Cd1314520/clawd-mochi/models/clawd_mochi/clawd_mochi_v1_holes_2.2mm.step

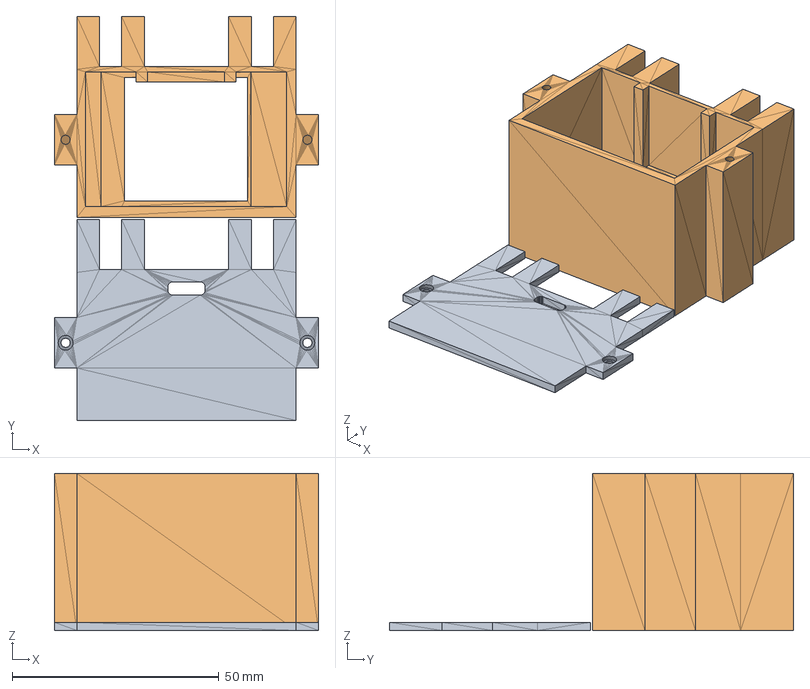
[picture p1: CAD file, 2026-10-28]
models/clawd_mochi/clawd_mochi_v1_holes_2.2mm.step
63.9 x 97.7 x 38.0 mm
