Cd1314520/clawd-mochi/(list of files, cad)

Other CAD files:
models/clawd_mochi/clawd_mochi_v1_holes_2.2mm.stl
