Cd1314520/clawd-mochi/clawd_mochi/clawd_mochi.ino

/*
 * ╔══════════════════════════════════════════════════════════════╗
 *   CLAWD MOCHI — ESP32-C3 Super Mini + ST7789 1.54" 240×240
 *
 *   Wiring:
 *     SDA → GPIO 10  (hardware SPI MOSI)
 *     SCL → GPIO 8   (hardware SPI SCK)
 *     RST → GPIO 2
 *     DC  → GPIO 1
 *     CS  → GPIO 4
 *     BL  → GPIO 3
 *     VCC → 3V3
 *     GND → GND
 *
 *   WiFi: "ClaWD-Mochi"  pw: clawd1234  → http://192.168.4.1
 *   (or set STA_SSID/STA_PASS below to join your home WiFi instead
 *    → http://clawdmochi.local)
 * ╚══════════════════════════════════════════════════════════════╝
 */

#include <Adafruit_GFX.h>
#include <Adafruit_ST7789.h>
#include <SPI.h>
#include <math.h>
#include <WiFi.h>
#include <WebServer.h>
#include <ESPmDNS.h>
#include <Update.h>
#include <time.h>

// ── Pins ──────────────────────────────────────────────────────
#define TFT_CS  4
#define TFT_DC  1
#define TFT_RST 2
#define TFT_BLK 3

Adafruit_ST7789 tft = Adafruit_ST7789(TFT_CS, TFT_DC, TFT_RST);

// ── WiFi ──────────────────────────────────────────────────────
const char* AP_SSID = "ClaWD-Mochi";
const char* AP_PASS = "clawd1234";

// Fill these in to join your home WiFi instead of hosting a hotspot —
// no more switching your phone's WiFi to reach Mochi. Leave STA_SSID
// empty ("") to keep the classic hotspot-only behaviour.
const char* STA_SSID = "";       // Fill locally; keep empty for hotspot mode.
const char* STA_PASS = "";       // Never commit your Wi-Fi password.
#define STA_TIMEOUT_MS 15000

WebServer server(80);

// ── Display ───────────────────────────────────────────────────
#define DISP_W 240
#define DISP_H 240

// ── Eye constants (shared by both eye views) ──────────────────
#define EYE_W   30
#define EYE_H   60
#define EYE_GAP 120
#define EYE_OX  0     // horizontal offset
#define EYE_OY  40    // vertical offset upward (subtracted from centre)

// ── Colours ───────────────────────────────────────────────────
uint16_t C_ORANGE, C_DARKBG, C_MUTED, C_GREEN;
#define C_WHITE ST77XX_WHITE
#define C_BLACK ST77XX_BLACK

// ── State ─────────────────────────────────────────────────────
#define VIEW_EYES_NORMAL 0
#define VIEW_EYES_SQUISH 1
#define VIEW_CODE        2
#define VIEW_DRAW        3

uint8_t  currentView  = VIEW_EYES_NORMAL;
bool     busy         = false;
bool     backlightOn  = true;
uint8_t  animSpeed    = 1;   // 1=slow(default) 2=normal 3=fast

uint16_t animBgColor  = 0;   // background for eye/logo animations
uint16_t drawBgColor  = 0;   // background for canvas

bool     uiStarted    = false;  // false until first view draw (keeps boot info screen)
uint32_t nextIdleAt   = 0;      // next random blink/glance
bool     staUp        = false;  // STA currently connected
uint32_t nextWifiTick = 0;      // next reconnect check
uint32_t wifiDownAt   = 0;      // when the connection was first seen down
bool     breathing    = false;  // backlight pulse = "unread notification"
bool     sleeping     = false;  // PC locked — eyes closed, slow dim breathing
uint8_t  faceIdx      = 0;      // which of the FACE_COUNT faces is showing
uint32_t nextFaceAt   = 0;      // next random face rotation

#define FACE_COUNT      10
#define FACE_MIN_MS  120000     // rotate every 2–6 min
#define FACE_RND_MS  240000

// ponytail: night hours hardcoded 00:00–08:00, tz Central (US)
#define TZ_STRING   "CST6CDT,M3.2.0,M11.1.0"
#define NIGHT_UNTIL 8
#define NIGHT_DUTY  25

// ── Terminal ──────────────────────────────────────────────────
#define TERM_COLS      15
#define TERM_ROWS       8
#define TERM_CHAR_W    12
#define TERM_CHAR_H    20
#define TERM_PAD_X      8
#define TERM_PAD_Y     18

bool    termMode    = false;
String  termLines[TERM_ROWS];
uint8_t termRow     = 0;
uint8_t termCol     = 0;

// ── Logo data ─────────────────────────────────────────────────
#define LOGO_CX 120
#define LOGO_CY 105

#define LOGO_TRI_COUNT 162
static const int16_t LOGO_TRIS[][6] PROGMEM = {
  {120,105,65,134,100,114},{120,105,100,114,101,113},{120,105,101,113,100,112},
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
  {136,76,144,67},{144,67,156,51},{156,51,162,45},{162,45,168,38},
  {168,38,172,35},{172,35,180,35},{180,35,185,43},{185,43,183,52},
  {183,52,175,62},{175,62,168,71},{168,71,159,83},{159,83,153,94},
  {153,94,154,94},{154,94,155,94},{155,94,176,90},{176,90,188,88},
  {188,88,201,85},{201,85,208,88},{208,88,208,91},{208,91,206,97},
  {206,97,191,101},{191,101,174,104},{174,104,148,110},{148,110,148,111},
  {148,111,148,111},{148,111,160,112},{160,112,165,112},{165,112,177,112},
  {177,112,200,114},{200,114,205,118},{205,118,209,123},{209,123,208,126},
  {208,126,199,131},{199,131,187,128},{187,128,159,121},{159,121,149,119},
  {149,119,147,119},{147,119,147,120},{147,120,156,128},{156,128,170,141},
  {170,141,189,158},{189,158,190,163},{190,163,188,166},{188,166,185,166},
  {185,166,169,153},{169,153,162,148},{162,148,148,136},{148,136,147,136},
  {147,136,147,137},{147,137,150,142},{150,142,168,168},{168,168,169,176},
  {169,176,168,179},{168,179,163,180},{163,180,158,179},{158,179,148,165},
  {148,165,137,149},{137,149,129,134},{129,134,128,135},{128,135,123,189},
  {123,189,120,192},{120,192,115,194},{115,194,110,191},{110,191,108,185},
  {108,185,110,174},{110,174,113,160},{113,160,116,148},{116,148,118,134},
  {118,134,119,129},{119,129,119,129},{119,129,118,129},{118,129,107,144},
  {107,144,91,166},{91,166,78,180},{78,180,75,181},{75,181,70,178},
  {70,178,70,173},{70,173,73,169},{73,169,91,146},{91,146,102,132},
  {102,132,109,124},{109,124,109,123},{109,123,108,123},{108,123,61,153},
  {61,153,52,155},{52,155,49,151},{49,151,49,146},{49,146,51,144},
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
};

// ═════════════════════════════════════════════════════════════
//  HELPERS
// ═════════════════════════════════════════════════════════════

int speedMs(int ms) {
  if (animSpeed == 3) return ms / 2;
  if (animSpeed == 1) return ms * 2;
  return ms;
}

uint16_t hexToRgb565(String hex) {
  hex.replace("#", "");
  if (hex.length() != 6) return C_WHITE;
  long v = strtol(hex.c_str(), nullptr, 16);
  return tft.color565((v >> 16) & 0xFF, (v >> 8) & 0xFF, v & 0xFF);
}

void setBacklight(bool on) { backlightOn = on; }  // blTick applies the duty

// Single owner of the backlight PWM: off / breathing pulse / night-dim / full.
void blTick() {
  static uint8_t lastDuty = 1;   // impossible initial so first call always writes
  uint8_t duty;
  if (!backlightOn) {
    duty = 0;
  } else if (sleeping) {
    duty = 14 + (int8_t)(10.0f * sinf(millis() / 1500.0f));  // slow, faint — asleep
  } else if (breathing) {
    duty = 130 + (int8_t)(110.0f * sinf(millis() / 500.0f));
  } else {
    duty = 255;
    struct tm t;
    if (getLocalTime(&t, 0) && t.tm_year > 120 && t.tm_hour < NIGHT_UNTIL)
      duty = NIGHT_DUTY;         // it stays up with you, but dims at night
  }
  if (duty != lastDuty) { ledcWrite(TFT_BLK, duty); lastDuty = duty; }
}

void initColours() {
  // C_ORANGE = tft.color565(170, 72, 28);
  C_ORANGE = tft.color565(218, 17, 0);
  C_DARKBG = tft.color565(10,  12,  16);
  C_MUTED  = tft.color565(90,  88,  86);
  C_GREEN  = tft.color565(80, 220, 130);
  animBgColor = C_ORANGE;
  drawBgColor = C_ORANGE;
}

// ═════════════════════════════════════════════════════════════
//  LOGO
// ═════════════════════════════════════════════════════════════

void drawLogoFilled(uint16_t bg, uint16_t fg) {
  tft.fillScreen(bg);
  for (uint16_t i = 0; i < LOGO_TRI_COUNT; i++) {
    tft.fillTriangle(
      pgm_read_word(&LOGO_TRIS[i][0]), pgm_read_word(&LOGO_TRIS[i][1]),
      pgm_read_word(&LOGO_TRIS[i][2]), pgm_read_word(&LOGO_TRIS[i][3]),
      pgm_read_word(&LOGO_TRIS[i][4]), pgm_read_word(&LOGO_TRIS[i][5]),
      fg);
  }
  tft.setTextColor(fg); tft.setTextSize(2);
  tft.setCursor(LOGO_CX - 54, 210); tft.print("Anthropic");
  tft.setCursor(LOGO_CX - 53, 210); tft.print("Anthropic");
}

// ═════════════════════════════════════════════════════════════
//  VIEWS
// ═════════════════════════════════════════════════════════════

// Eye helpers — shared constants via #define EYE_*
inline int16_t eyeLX(int16_t ox) {
  return (DISP_W - (EYE_W * 2 + EYE_GAP)) / 2 + EYE_OX + ox;
}
inline int16_t eyeRX(int16_t ox) { return eyeLX(ox) + EYE_W + EYE_GAP; }
inline int16_t eyeY()            { return (DISP_H - EYE_H) / 2 - EYE_OY; }
inline int16_t eyeCY()           { return eyeY() + EYE_H / 2; }

void drawNormalEyes(int16_t ox = 0, bool blink = false) {
  uiStarted = true;
  tft.fillScreen(animBgColor);
  const int16_t lx = eyeLX(ox), rx = eyeRX(ox), ey = eyeY();
  if (!blink) {
    tft.fillRect(lx, ey, EYE_W, EYE_H, C_BLACK);
    tft.fillRect(rx, ey, EYE_W, EYE_H, C_BLACK);
  } else {
    tft.fillRect(lx, ey + EYE_H / 2 - 3, EYE_W, 6, C_BLACK);
    tft.fillRect(rx, ey + EYE_H / 2 - 3, EYE_W, 6, C_BLACK);
  }
}

void drawChevron(int16_t cx, int16_t cy, int16_t arm, int16_t reach,
                 uint8_t thk, bool rightFacing, uint16_t col) {
  for (int8_t t = -(int8_t)thk; t <= (int8_t)thk; t++) {
    if (rightFacing) {
      tft.drawLine(cx - reach/2, cy - arm + t, cx + reach/2, cy + t,      col);
      tft.drawLine(cx + reach/2, cy + t,       cx - reach/2, cy + arm + t, col);
    } else {
      tft.drawLine(cx + reach/2, cy - arm + t, cx - reach/2, cy + t,      col);
      tft.drawLine(cx - reach/2, cy + t,       cx + reach/2, cy + arm + t, col);
    }
  }
}

void drawSquishEyes(bool closed = false) {
  uiStarted = true;
  tft.fillScreen(animBgColor);
  const int16_t lx = eyeLX(0), rx = eyeRX(0), cy = eyeCY();
  const int16_t arm   = EYE_H / 2;
  const int16_t reach = EYE_W / 2;
  const int16_t lcx   = lx + EYE_W / 2;
  const int16_t rcx   = rx + EYE_W / 2;
  if (!closed) {
    drawChevron(lcx, cy, arm, reach, 10, true,  C_BLACK);
    drawChevron(rcx, cy, arm, reach, 10, false, C_BLACK);
  } else {
    tft.fillRect(lx, cy - 5, EYE_W, 10, C_BLACK);
    tft.fillRect(rx, cy - 5, EYE_W, 10, C_BLACK);
  }
}

// ── Extra faces (2–9) — all drawn at the standard eye positions ──
void drawFaceSleepy() {          // 2: half-lidded
  uiStarted = true;
  tft.fillScreen(animBgColor);
  tft.fillRect(eyeLX(0), eyeY() + EYE_H / 2, EYE_W, EYE_H / 2, C_BLACK);
  tft.fillRect(eyeRX(0), eyeY() + EYE_H / 2, EYE_W, EYE_H / 2, C_BLACK);
}

void drawFaceWide() {            // 3: surprised round eyes with a glint
  uiStarted = true;
  tft.fillScreen(animBgColor);
  const int16_t cy = eyeCY();
  for (int8_t s = 0; s < 2; s++) {
    const int16_t cx = (s ? eyeRX(0) : eyeLX(0)) + EYE_W / 2;
    tft.fillCircle(cx, cy, EYE_W, C_BLACK);
    tft.fillCircle(cx + 9, cy - 9, 6, C_WHITE);
  }
}

void drawFaceWink() {            // 4: left open, right closed
  uiStarted = true;
  tft.fillScreen(animBgColor);
  tft.fillRect(eyeLX(0), eyeY(), EYE_W, EYE_H, C_BLACK);
  tft.fillRect(eyeRX(0), eyeCY() - 4, EYE_W, 8, C_BLACK);
}

void drawHeart(int16_t cx, int16_t cy, int16_t s, uint16_t col) {
  tft.fillCircle(cx - s / 2, cy - s / 3, s / 2 + 2, col);
  tft.fillCircle(cx + s / 2, cy - s / 3, s / 2 + 2, col);
  tft.fillTriangle(cx - s - 1, cy - s / 6, cx + s + 1, cy - s / 6, cx, cy + s, col);
}

void drawFaceHearts() {          // 5: heart eyes
  uiStarted = true;
  tft.fillScreen(animBgColor);
  const uint16_t red = tft.color565(235, 30, 60);
  drawHeart(eyeLX(0) + EYE_W / 2, eyeCY(), 20, red);
  drawHeart(eyeRX(0) + EYE_W / 2, eyeCY(), 20, red);
}

void drawFaceDizzy() {           // 6: X X eyes
  uiStarted = true;
  tft.fillScreen(animBgColor);
  for (int8_t s = 0; s < 2; s++) {
    const int16_t x = s ? eyeRX(0) : eyeLX(0), y = eyeCY() - EYE_W / 2;
    for (int8_t t = -3; t <= 3; t++) {
      tft.drawLine(x + t, y, x + EYE_W + t, y + EYE_W, C_BLACK);
      tft.drawLine(x + EYE_W + t, y, x + t, y + EYE_W, C_BLACK);
    }
  }
}

void drawFaceAngry() {           // 7: slanted inner brows over rect eyes
  uiStarted = true;
  tft.fillScreen(animBgColor);
  const int16_t lx = eyeLX(0), rx = eyeRX(0), ey = eyeY();
  tft.fillRect(lx, ey, EYE_W, EYE_H, C_BLACK);
  tft.fillRect(rx, ey, EYE_W, EYE_H, C_BLACK);
  tft.fillTriangle(lx, ey, lx + EYE_W, ey, lx + EYE_W, ey + 20, animBgColor);  // inner = right
  tft.fillTriangle(rx, ey + 20, rx, ey, rx + EYE_W, ey, animBgColor);          // inner = left
}

void drawFaceSus() {             // 8: narrow side-eye squint
  uiStarted = true;
  tft.fillScreen(animBgColor);
  tft.fillRect(eyeLX(10), eyeCY() - 9, EYE_W, 18, C_BLACK);
  tft.fillRect(eyeRX(10), eyeCY() - 9, EYE_W, 18, C_BLACK);
}

void drawFaceContent() {         // 9: happy closed arcs (∩ ∩)
  uiStarted = true;
  tft.fillScreen(animBgColor);
  const int16_t cy = eyeCY();
  for (int8_t s = 0; s < 2; s++) {
    const int16_t cx = (s ? eyeRX(0) : eyeLX(0)) + EYE_W / 2;
    tft.fillCircle(cx, cy, EYE_W / 2 + 6, C_BLACK);
    tft.fillCircle(cx, cy, EYE_W / 2 - 3, animBgColor);
    tft.fillRect(cx - EYE_W / 2 - 7, cy, EYE_W + 14, EYE_W / 2 + 8, animBgColor);
  }
}

void drawFace(uint8_t i) {
  switch (i) {
    default:
    case 0: drawNormalEyes();   break;
    case 1: drawSquishEyes();   break;
    case 2: drawFaceSleepy();   break;
    case 3: drawFaceWide();     break;
    case 4: drawFaceWink();     break;
    case 5: drawFaceHearts();   break;
    case 6: drawFaceDizzy();    break;
    case 7: drawFaceAngry();    break;
    case 8: drawFaceSus();      break;
    case 9: drawFaceContent();  break;
  }
}

void drawCodeView() {
  termMode = false;
  tft.fillScreen(C_DARKBG);
  tft.fillRect(0, 0,          DISP_W, 4, C_ORANGE);
  tft.fillRect(0, DISP_H - 4, DISP_W, 4, C_ORANGE);
  tft.setTextColor(C_ORANGE); tft.setTextSize(4);
  tft.setCursor((DISP_W - 144) / 2, DISP_H / 2 - 52); tft.print("Claude");
  tft.setTextColor(C_WHITE);  tft.setTextSize(4);
  tft.setCursor((DISP_W - 96) / 2,  DISP_H / 2 + 8);  tft.print("Code");
  tft.fillRect((DISP_W - 96) / 2, DISP_H / 2 + 52, 96, 3, C_ORANGE);
}

// ═════════════════════════════════════════════════════════════
//  TERMINAL
// ═════════════════════════════════════════════════════════════

void termClear() {
  for (uint8_t i = 0; i < TERM_ROWS; i++) termLines[i] = "";
  termRow = 0; termCol = 0;
}

void termDrawHeader() {
  tft.fillRect(0, 0, DISP_W, TERM_PAD_Y + 1, C_DARKBG);
  tft.setTextColor(C_ORANGE); tft.setTextSize(1);
  tft.setCursor(TERM_PAD_X, 4); tft.print("clawd@mochi terminal");
  tft.drawFastHLine(0, TERM_PAD_Y, DISP_W, C_ORANGE);
}

// Prefix "clawd:~$ " in green, drawn only when the row has content
void termDrawPrefix(int16_t yy) {
  tft.setTextColor(C_GREEN); tft.setTextSize(1);
  tft.setCursor(TERM_PAD_X, yy + 6);
  tft.print("clawd:~$ ");
}

#define PREFIX_PX 54   // 9 chars × 6px = 54px at textSize 1

void termDrawLine(uint8_t r) {
  const int16_t yy = TERM_PAD_Y + 4 + r * TERM_CHAR_H;
  tft.fillRect(0, yy, DISP_W, TERM_CHAR_H, C_DARKBG);
  // show prefix only on the currently active (cursor) line
  if (r == termRow) termDrawPrefix(yy);
  tft.setTextColor(C_WHITE); tft.setTextSize(2);
  tft.setCursor(TERM_PAD_X + PREFIX_PX, yy + 1);
  tft.print(termLines[r]);
  if (r == termRow) {
    const int16_t cx = TERM_PAD_X + PREFIX_PX + termCol * TERM_CHAR_W;
    tft.fillRect(cx, yy + 1, TERM_CHAR_W - 2, TERM_CHAR_H - 2, C_GREEN);
  }
}

void termDrawLastChar() {
  if (termCol == 0) return;
  const int16_t yy    = TERM_PAD_Y + 4 + termRow * TERM_CHAR_H;
  const int16_t baseX = TERM_PAD_X + PREFIX_PX;
  const uint8_t prev  = termCol - 1;
  // erase prev cell (had cursor block)
  tft.fillRect(baseX + prev * TERM_CHAR_W, yy + 1, TERM_CHAR_W, TERM_CHAR_H - 1, C_DARKBG);
  tft.setTextColor(C_WHITE); tft.setTextSize(2);
  tft.setCursor(baseX + prev * TERM_CHAR_W, yy + 1);
  tft.print(termLines[termRow][prev]);
  // new cursor
  tft.fillRect(baseX + termCol * TERM_CHAR_W, yy + 1, TERM_CHAR_W - 2, TERM_CHAR_H - 2, C_GREEN);
}

void termDrawBackspace() {
  const int16_t yy    = TERM_PAD_Y + 4 + termRow * TERM_CHAR_H;
  const int16_t baseX = TERM_PAD_X + PREFIX_PX;
  // erase deleted char + old cursor
  tft.fillRect(baseX + termCol * TERM_CHAR_W, yy + 1, TERM_CHAR_W * 2, TERM_CHAR_H - 1, C_DARKBG);
  // new cursor
  tft.fillRect(baseX + termCol * TERM_CHAR_W, yy + 1, TERM_CHAR_W - 2, TERM_CHAR_H - 2, C_GREEN);
  // if line now empty, erase the prefix too
  if (termLines[termRow].length() == 0) {
    tft.fillRect(0, yy, TERM_PAD_X + PREFIX_PX, TERM_CHAR_H, C_DARKBG);
  }
}

void termFullRedraw() {
  tft.fillScreen(C_DARKBG);
  termDrawHeader();
  for (uint8_t r = 0; r < TERM_ROWS; r++) termDrawLine(r);
}

void termScroll() {
  for (uint8_t i = 0; i < TERM_ROWS - 1; i++) termLines[i] = termLines[i + 1];
  termLines[TERM_ROWS - 1] = "";
  termRow = TERM_ROWS - 1;
  termFullRedraw();
}

void termAddChar(char c) {
  if (c == '\n' || c == '\r') {
    const int16_t yy = TERM_PAD_Y + 4 + termRow * TERM_CHAR_H;
    // erase cursor on current row
    tft.fillRect(TERM_PAD_X + PREFIX_PX + termCol * TERM_CHAR_W,
                 yy + 1, TERM_CHAR_W, TERM_CHAR_H - 1, C_DARKBG);
    termRow++; termCol = 0;
    if (termRow >= TERM_ROWS) { termScroll(); return; }
    termDrawLine(termRow);  // draws prefix on new line
  } else if (c == '\b' || c == 127) {
    if (termCol > 0) {
      termCol--;
      termLines[termRow].remove(termLines[termRow].length() - 1);
      termDrawBackspace();
    }
  } else if (c >= 32 && c < 127) {
    if (termCol >= TERM_COLS) {
      termRow++; termCol = 0;
      if (termRow >= TERM_ROWS) { termScroll(); return; }
    }
    // draw prefix on first char of this line
    if (termCol == 0) termDrawPrefix(TERM_PAD_Y + 4 + termRow * TERM_CHAR_H);
    termLines[termRow] += c;
    termCol++;
    termDrawLastChar();
  }
}

// ═════════════════════════════════════════════════════════════
//  ANIMATIONS
// ═════════════════════════════════════════════════════════════

void animNormalEyes() {
  busy = true;
  const int16_t offs[] = {-16, 16, -16, 16, 0};
  for (uint8_t i = 0; i < 5; i++) { drawNormalEyes(offs[i]); delay(speedMs(80)); }
  drawNormalEyes(0, true);  delay(speedMs(100));
  drawNormalEyes(0, false); delay(speedMs(70));
  drawNormalEyes(0, true);  delay(speedMs(70));
  drawNormalEyes(0, false);
  busy = false;
}

void animSquishEyes() {
  busy = true;
  for (uint8_t i = 0; i < 3; i++) {
    drawSquishEyes(false); delay(speedMs(160));
    drawSquishEyes(true);  delay(speedMs(100));
  }
  drawSquishEyes(false);
  busy = false;
}

void animLogoReveal() {
  busy = true;
  tft.fillScreen(animBgColor);
  for (uint16_t i = 0; i < LOGO_SEG_COUNT; i++) {
    int16_t x1 = pgm_read_word(&LOGO_SEGS[i][0]);
    int16_t y1 = pgm_read_word(&LOGO_SEGS[i][1]);
    int16_t x2 = pgm_read_word(&LOGO_SEGS[i][2]);
    int16_t y2 = pgm_read_word(&LOGO_SEGS[i][3]);
    tft.drawLine(x1, y1, x2, y2, C_WHITE);
    tft.drawLine(x1 + 1, y1, x2 + 1, y2, C_WHITE);
    if (i % 4 == 0) { server.handleClient(); delay(speedMs(8)); }
  }
  drawLogoFilled(animBgColor, C_WHITE);
  delay(1500);
  busy = false;
}

// ── Idle life — random blinks, glances & face rotation ─────────
void idleTick() {
  if (!uiStarted || busy || termMode || sleeping) return;
  if (currentView != VIEW_EYES_NORMAL && currentView != VIEW_EYES_SQUISH) return;
  if (millis() < nextIdleAt) return;

  // every few minutes: swap to a random face
  if (nextFaceAt == 0) nextFaceAt = millis() + FACE_MIN_MS + random(FACE_RND_MS);
  if (millis() > nextFaceAt) {
    faceIdx = random(FACE_COUNT);
    busy = true; drawFace(faceIdx); busy = false;
    nextFaceAt = millis() + FACE_MIN_MS + random(FACE_RND_MS);
    nextIdleAt = millis() + 2500 + random(4500);
    return;
  }

  busy = true;
  if (faceIdx == 0) {
    if (random(4) == 0) {                       // 1-in-4: glance to the side
      drawNormalEyes(random(2) ? 14 : -14);
      delay(280);
      drawNormalEyes(0);
    } else {                                    // otherwise: blink
      drawNormalEyes(0, true);
      delay(110);
      drawNormalEyes(0, false);
    }
  } else if (faceIdx == 1) {
    drawSquishEyes(true);
    delay(120);
    drawSquishEyes(false);
  }                                             // other faces hold still until rotation
  busy = false;
  nextIdleAt = millis() + 2500 + random(4500);  // next one in 2.5–7 s
}

// Static IP so /notify scripts never chase a DHCP lease — must be re-declared
// on every (re)join or the driver silently falls back to DHCP.
// ponytail: hardcoded to the Windows-hotspot subnet (gateway .1)
void staBegin() {
  WiFi.config(IPAddress(192,168,137,50), IPAddress(192,168,137,1),
              IPAddress(255,255,255,0), IPAddress(192,168,137,1));
  WiFi.begin(STA_SSID, STA_PASS);
}

// ── WiFi self-heal — the PC hotspot comes and goes with sleep ──
// Reconnects when the hotspot returns; also rescues the boot-time
// AP-fallback case without needing a USB replug.
void wifiTick() {
  if (strlen(STA_SSID) == 0 || millis() < nextWifiTick) return;
  nextWifiTick = millis() + 10000;
  if (WiFi.status() == WL_CONNECTED) {
    wifiDownAt = 0;
    if (!staUp) {                 // just (re)joined — e.g. recovered from AP fallback
      staUp = true;
      WiFi.setSleep(false);
      MDNS.begin("clawdmochi");
    }
    return;
  }
  staUp = false;
  if (wifiDownAt == 0) wifiDownAt = millis();
  // Asleep with no network for 10+ min: the wake command can never reach us,
  // so stop looking dead and wake up on our own.
  if (sleeping && millis() - wifiDownAt > 600000) {
    sleeping = false;
    animNormalEyes();
  }
  // ponytail: screen keeps whatever it shows during retries; IP is on /state
  if (WiFi.getMode() == WIFI_AP) WiFi.mode(WIFI_AP_STA);  // keep AP alive as fallback
  staBegin();
}

// ═════════════════════════════════════════════════════════════
//  WEB PAGE
// ═════════════════════════════════════════════════════════════
const char INDEX_HTML[] PROGMEM = R"rawhtml(
<!DOCTYPE html>
<html lang="en">
<head>
<meta charset="UTF-8">
<meta name="viewport" content="width=device-width,initial-scale=1,user-scalable=no">
<title>Clawd Mochi</title>
<style>
*{box-sizing:border-box;margin:0;padding:0;-webkit-tap-highlight-color:transparent}
body{background:#1c1c20;font-family:'Courier New',monospace;color:#e8e4dc;
  display:flex;flex-direction:column;align-items:center;
  padding:20px 14px 52px;gap:14px;min-height:100vh}

.hdr{text-align:center;padding:2px 0 4px}
.mascot{font-size:15px;color:#c96a3e;line-height:1.3;font-weight:bold;
  font-family:'Courier New',monospace;display:block;letter-spacing:1px}
.sitename{font-size:10px;color:#5a5048;margin-top:8px;letter-spacing:3px}

.sec{width:100%;max-width:390px;font-size:10px;color:#8a8278;
  letter-spacing:2px;font-weight:bold;padding:0 2px}

/* Busy bar */
.busy{width:100%;max-width:390px;height:2px;background:#2e2a28;
  border-radius:1px;overflow:hidden;opacity:0;transition:opacity .2s}
.busy.show{opacity:1}
.busy-i{height:100%;width:30%;background:#c96a3e;border-radius:1px;
  animation:sl 1s linear infinite}
@keyframes sl{0%{margin-left:-30%}100%{margin-left:100%}}

/* Controls */
.ctrl{display:flex;gap:8px;width:100%;max-width:390px}
.cbtn{flex:1;background:#252428;border:1.5px solid #38343a;border-radius:10px;
  color:#b8b4ac;font-family:'Courier New',monospace;font-size:11px;font-weight:bold;
  padding:12px 4px;cursor:pointer;text-align:center;transition:all .12s}
.cbtn:active:not(:disabled){transform:scale(.94)}
.cbtn:disabled{opacity:.3;cursor:default}
.cbtn.on{border-color:#c96a3e;color:#c96a3e;background:#201408}
.cbtn.dim{border-color:#2e2a28;color:#4a4540}

/* View grid */
.vgrid{display:grid;grid-template-columns:1fr 1fr;gap:8px;width:100%;max-width:390px}
.vbtn{background:#252428;border:1.5px solid #38343a;border-radius:12px;
  color:#d8d4cc;font-family:'Courier New',monospace;
  padding:14px 6px 10px;cursor:pointer;text-align:center;
  transition:all .12s;user-select:none}
.vbtn:active:not(:disabled){transform:scale(.94)}
.vbtn:disabled{opacity:.3;cursor:default}
.vbtn .ic{font-size:20px;display:block;margin-bottom:4px;line-height:1;color:#c96a3e}
.vbtn .nm{font-size:12px;font-weight:bold;color:#e8e4dc}
.vbtn .ht{font-size:9px;color:#8a8278;margin-top:3px}
.vbtn.active{border-color:#c96a3e;background:#201408}
.vbtn[data-v="1"].active{border-color:#c96a3e;background:#201408}
.vbtn[data-v="2"].active{border-color:#4a8acd;background:#0c1628}
.vbtn[data-v="3"].active{border-color:#38343a;background:#201c18}

/* Speed slider */
.speed-row{width:100%;max-width:390px;display:flex;align-items:center;gap:10px}
.sl{font-size:10px;color:#6a6058;white-space:nowrap;min-width:36px}
input[type=range]{flex:1;accent-color:#c96a3e;cursor:pointer;height:20px}
.sv{font-size:11px;color:#c96a3e;min-width:44px;text-align:right;font-weight:bold}

/* Terminal */
.twrap{width:100%;max-width:390px;display:none;flex-direction:column;gap:8px}
.twrap.open{display:flex}
.thdr{display:flex;justify-content:space-between;align-items:center}
.tttl{font-size:11px;color:#28b878;letter-spacing:1px;font-weight:bold}
.tx{background:#0c1e12;border:2px solid #1a4828;border-radius:9px;
  color:#28b878;font-family:'Courier New',monospace;font-size:13px;
  font-weight:bold;padding:10px 18px;cursor:pointer}
.tx:active{background:#081410}
.trow{display:flex;gap:6px}
.tin{flex:1;background:#0c1018;border:1.5px solid #1a2820;border-radius:9px;
  color:#40d880;font-family:'Courier New',monospace;font-size:15px;
  padding:11px;outline:none}
.tin::placeholder{color:#2a3828}
.tgo{background:#1a9060;border:none;border-radius:9px;color:#fff;
  font-family:'Courier New',monospace;font-size:22px;font-weight:bold;
  padding:11px 16px;cursor:pointer;min-width:52px}
.tgo:active{background:#0f6040}

/* Canvas */
.cwrap{width:100%;max-width:390px;background:#222028;border:1.5px solid #38343a;
  border-radius:12px;padding:12px;flex-direction:column;gap:10px;display:none}
.cwrap.open{display:flex}
.crow{display:flex;gap:8px}
.ci{display:flex;flex-direction:column;align-items:center;gap:4px;flex:1}
.cl{font-size:10px;color:#7a7068;letter-spacing:1px;font-weight:bold}
.cs{width:100%;height:38px;border-radius:7px;border:1.5px solid #38343a;cursor:pointer;padding:0}
.dacts{display:flex;gap:7px}
.db{flex:1;background:#1c1820;border:1.5px solid #38343a;border-radius:9px;
  color:#c0bab8;font-family:'Courier New',monospace;font-size:11px;
  font-weight:bold;padding:11px 4px;cursor:pointer;transition:all .12s}
.db:active{transform:scale(.95);background:#281838}
.db.hi{border-color:#c96a3e;color:#c96a3e}
canvas{width:100%;border-radius:8px;border:1.5px solid #38343a;
  touch-action:none;cursor:crosshair;display:block}

/* Toast */
.toast{position:fixed;bottom:18px;left:50%;transform:translateX(-50%);
  background:#252428;border:1.5px solid #38343a;border-radius:9px;
  font-size:12px;color:#d8d4cc;padding:7px 16px;opacity:0;
  transition:opacity .18s;pointer-events:none;white-space:nowrap;z-index:99}
.toast.show{opacity:1}
</style>
</head>
<body>

<div class="hdr">
  <span class="mascot">&#x2590;&#x259B;&#x2588;&#x2588;&#x2588;&#x259C;&#x258C;<br>&#x259C;&#x2588;&#x2588;&#x2588;&#x2588;&#x2588;&#x259B;<br>&#x2598;&#x2598;&nbsp;&#x259D;&#x259D;</span>
  <div class="sitename">CLAWD &middot; MOCHI &middot; CONTROLLER</div>
</div>

<div class="busy" id="busy"><div class="busy-i"></div></div>

<div class="sec">// controls</div>
<div class="ctrl">
  <button class="cbtn on" id="blBtn" onclick="toggleBL()">&#9728; display on</button>
</div>

<div class="sec">// views</div>
<div class="vgrid">
  <button class="vbtn active" data-v="0" onclick="setView(0)">
    <span class="ic">&#9632; &#9632;</span>
    <span class="nm">Normal eyes</span>
    <span class="ht">wiggle + blink</span>
  </button>
  <button class="vbtn" data-v="1" onclick="setView(1)">
    <span class="ic">&gt; &lt;</span>
    <span class="nm">Squish eyes</span>
    <span class="ht">open / close</span>
  </button>
  <button class="vbtn" data-v="2" onclick="setView(2)">
    <span class="ic">{ }</span>
    <span class="nm">Claude Code</span>
    <span class="ht">opens terminal</span>
  </button>
  <button class="vbtn" data-v="3" onclick="toggleCanvas()">
    <span class="ic">&#11035;</span>
    <span class="nm">Canvas</span>
    <span class="ht">draw on display</span>
  </button>
</div>

<div class="sec">// speed</div>
<div class="speed-row">
  <span class="sl">slow</span>
  <input type="range" id="spd" min="1" max="3" value="1" step="1" oninput="setSpeed(this.value)">
  <span class="sv" id="spdV">slow</span>
</div>

<div class="ctrl">
  <div class="ci" style="flex:1;display:flex;flex-direction:column;gap:4px;align-items:stretch">
    <span class="cl" style="font-size:10px;color:#8a8278;letter-spacing:1px;font-weight:bold;text-align:center">BACKGROUND</span>
    <input type="color" class="cs" id="bgCol" value="#aa4818" oninput="onBgChange(this.value)">
  </div>
  <div class="ci" style="flex:1;display:flex;flex-direction:column;gap:4px;align-items:stretch">
    <span class="cl" style="font-size:10px;color:#8a8278;letter-spacing:1px;font-weight:bold;text-align:center">PEN COLOR</span>
    <input type="color" class="cs" id="penCol" value="#000000">
  </div>
</div>

<div class="sec">// terminal</div>
<div class="twrap" id="twrap">
  <div class="thdr">
    <span class="tttl">&#9658; clawd:~$</span>
    <button class="tx" onclick="closeTerm()">&#x2715; exit terminal</button>
  </div>
  <div class="trow">
    <input class="tin" id="tin" type="text" placeholder="type here..."
           autocomplete="off" autocorrect="off" autocapitalize="off" spellcheck="false">
    <button class="tgo" onclick="termEnter()">&#8629;</button>
  </div>
</div>

<div class="cwrap" id="cwrap">
  <div class="dacts">
    <button class="db hi" onclick="clearAll()">&#11035; clear</button>
    <button class="db" style="border-color:#28b878;color:#28b878" onclick="toggleCanvas()">&#10003; done</button>
  </div>
  <canvas id="cvs" width="240" height="240"></canvas>
</div>

<div class="toast" id="toast"></div>

<script>
let activeView  = 0;
let termOpen    = false;
let canvasOpen  = false;
let blOn        = true;
let isBusy      = false;
let drawing     = false;
let lastX = 0, lastY = 0;
let tt;

const spdLabels = ['','slow','normal','fast'];

// ── Toast ──────────────────────────────────────────────────────
function toast(msg, ok=true) {
  const el = document.getElementById('toast');
  el.textContent = msg;
  el.style.borderColor = ok ? '#28b878' : '#c96a3e';
  el.classList.add('show');
  clearTimeout(tt);
  tt = setTimeout(() => el.classList.remove('show'), 1300);
}

// ── Busy ────────────────────────────────────────────────────────
function setBusy(b) {
  isBusy = b;
  document.getElementById('busy').classList.toggle('show', b);
  const locked = b || termOpen;
  document.querySelectorAll('.vbtn').forEach(el => {
    // when canvas open, keep canvas btn (data-v=3) active so user can exit
    el.disabled = canvasOpen ? parseInt(el.dataset.v) !== 3 : locked;
  });
  document.querySelectorAll('.lbtn').forEach(el => el.disabled = locked || canvasOpen);
  document.querySelectorAll('.cbtn').forEach(el => {
    if (el.id !== 'blBtn') el.disabled = locked;
  });
}

// ── HTTP ────────────────────────────────────────────────────────
async function req(path) {
  try { const r = await fetch(path); return r.ok; }
  catch(e) { toast('no connection', false); return false; }
}

async function waitNotBusy() {
  for (let i = 0; i < 100; i++) {
    try {
      const r = await fetch('/state');
      const j = await r.json();
      if (!j.busy) return;
    } catch(e) {}
    await new Promise(r => setTimeout(r, 150));
  }
}

// ── Background colour ───────────────────────────────────────────
async function onBgChange(hex) {
  if (canvasOpen) {
    await req('/draw/clear?bg=' + encodeURIComponent(hex));
  } else {
    await req('/redraw?bg=' + encodeURIComponent(hex));
  }
  redrawCanvas(hex);
}

// ── Speed ───────────────────────────────────────────────────────
async function setSpeed(v) {
  document.getElementById('spdV').textContent = spdLabels[v];
  await req('/speed?v=' + v);
}

// ── Views ───────────────────────────────────────────────────────
async function setView(v) {
  if (isBusy || termOpen || canvasOpen) return;
  if (v === 3) { toggleCanvas(); return; }  // canvas button in grid
  const keys = ['w','s','d'];
  if (!await req('/cmd?k=' + keys[v])) return;
  activeView = v;
  document.querySelectorAll('.vbtn').forEach(b =>
    b.classList.toggle('active', parseInt(b.dataset.v) === v));
  if (v === 2) {
    termOpen = true;
    document.getElementById('twrap').classList.add('open');
    setBusy(false);   // re-run to apply termOpen lock
    setBusy(false);
    document.querySelectorAll('.vbtn,.lbtn').forEach(b => b.disabled = true);
    const cvb = document.getElementById('cvBtn'); if (cvb) cvb.disabled = true;
    document.getElementById('tin').focus();
    toast('terminal open');
    return;
  }
  setBusy(true);
  await waitNotBusy();
  setBusy(false);
}

// ── Logo animations (kept for startup, not exposed in UI) ──────

// ── Backlight ───────────────────────────────────────────────────
async function toggleBL() {
  blOn = !blOn;
  await req('/backlight?on=' + (blOn ? 1 : 0));
  const b = document.getElementById('blBtn');
  b.textContent = blOn ? '\u2600 display on' : '\u25cb display off';
  b.classList.toggle('on', blOn);
  b.classList.toggle('dim', !blOn);
}

// ── Canvas toggle ───────────────────────────────────────────────
async function toggleCanvas() {
  canvasOpen = !canvasOpen;
  document.getElementById('cwrap').classList.toggle('open', canvasOpen);
  const b = document.getElementById('cvBtn');
  if (b) { b.classList.toggle('on', canvasOpen); b.textContent = canvasOpen ? '\u2b1b canvas on' : '\u2b1b canvas'; }
  // highlight the canvas vbtn (data-v=3) in the grid
  document.querySelectorAll('.vbtn').forEach(btn =>
    btn.classList.toggle('active', canvasOpen && parseInt(btn.dataset.v) === 3));
  await req('/canvas?on=' + (canvasOpen ? 1 : 0));
  if (canvasOpen) {
    const bg = document.getElementById('bgCol').value;
    redrawCanvas(bg);
    await req('/draw/clear?bg=' + encodeURIComponent(bg));
    // lock all other buttons
    document.querySelectorAll('.vbtn,.lbtn').forEach(b => b.disabled = true);
    toast('canvas active');
  } else {
    setBusy(false);   // re-evaluate locks
    toast('canvas off');
  }
}

// ── Terminal ────────────────────────────────────────────────────
const tin = document.getElementById('tin');
let lastVal = '';
tin.addEventListener('input', async () => {
  const cur = tin.value, prev = lastVal;
  if (cur.length > prev.length) {
    await req('/char?c=' + encodeURIComponent(cur[cur.length - 1]));
  } else if (cur.length < prev.length) {
    await req('/char?c=%08');
  }
  lastVal = cur;
});
async function termEnter() {
  await req('/char?c=%0A');
  tin.value = ''; lastVal = ''; tin.focus();
}
tin.addEventListener('keydown', e => {
  if (e.key === 'Enter') { e.preventDefault(); termEnter(); }
});
async function closeTerm() {
  await req('/cmd?k=q');
  termOpen = false;
  document.getElementById('twrap').classList.remove('open');
  setBusy(false);
  toast('terminal closed');
}

// ── Canvas drawing — send full stroke on finger lift ────────────
const cvs = document.getElementById('cvs');
const ctx = cvs.getContext('2d');
let strokePts = [];

function getPos(e) {
  const r = cvs.getBoundingClientRect();
  const sx = cvs.width / r.width, sy = cvs.height / r.height;
  const s = e.touches ? e.touches[0] : e;
  return { x: (s.clientX - r.left) * sx, y: (s.clientY - r.top) * sy };
}

function redrawCanvas(hex) {
  ctx.fillStyle = hex;
  ctx.fillRect(0, 0, cvs.width, cvs.height);
}

function startDraw(e) {
  e.preventDefault();
  drawing = true;
  strokePts = [];
  const p = getPos(e); lastX = p.x; lastY = p.y;
  strokePts.push({ x: Math.round(p.x), y: Math.round(p.y) });
  // draw dot on canvas preview only — no display send yet
  ctx.beginPath(); ctx.arc(p.x, p.y, 2, 0, Math.PI * 2);
  ctx.fillStyle = document.getElementById('penCol').value; ctx.fill();
}
function moveDraw(e) {
  if (!drawing) return; e.preventDefault();
  const p = getPos(e);
  ctx.beginPath(); ctx.moveTo(lastX, lastY); ctx.lineTo(p.x, p.y);
  ctx.strokeStyle = document.getElementById('penCol').value;
  ctx.lineWidth = 4; ctx.lineCap = 'round'; ctx.stroke();
  strokePts.push({ x: Math.round(p.x), y: Math.round(p.y) });
  lastX = p.x; lastY = p.y;
}
async function endDraw(e) {
  if (!drawing) return; drawing = false;
  if (!canvasOpen || strokePts.length < 1) return;
  const pen = document.getElementById('penCol').value.replace('#', '');
  const pts = strokePts.map(p => p.x + ',' + p.y).join(';');
  await req('/draw/stroke?pen=' + pen + '&pts=' + encodeURIComponent(pts));
  strokePts = [];
}

cvs.addEventListener('mousedown',  startDraw);
cvs.addEventListener('mousemove',  moveDraw);
cvs.addEventListener('mouseup',    endDraw);
cvs.addEventListener('mouseleave', endDraw);
cvs.addEventListener('touchstart', startDraw, {passive:false});
cvs.addEventListener('touchmove',  moveDraw,  {passive:false});
cvs.addEventListener('touchend',   endDraw);

// Clear = clear both web canvas and display
async function clearAll() {
  const bg = document.getElementById('bgCol').value;
  redrawCanvas(bg);
  await req('/draw/clear?bg=' + encodeURIComponent(bg));
  toast('cleared');
}

// Init: sync speed and backlight from ESP32, reset bg to default
(async () => {
  try {
    const r = await fetch('/state');
    const j = await r.json();
    // Sync speed
    const spd = j.speed || 1;
    document.getElementById('spd').value = spd;
    document.getElementById('spdV').textContent = spdLabels[spd];
    // Sync backlight
    if (j.bl === false) {
      blOn = false;
      const b = document.getElementById('blBtn');
      b.textContent = '\u25cb display off';
      b.classList.remove('on'); b.classList.add('dim');
    }
  } catch(e) {}
  // Always reset bg picker to default orange on page load
  document.getElementById('bgCol').value = '#aa4818';
  redrawCanvas('#aa4818');
})();
</script>
</body>
</html>
)rawhtml";

// ═════════════════════════════════════════════════════════════
//  WEB ROUTES
// ═════════════════════════════════════════════════════════════

void routeRoot() {
  server.sendHeader("Cache-Control", "no-store, no-cache, must-revalidate");
  server.sendHeader("Pragma", "no-cache");
  server.send_P(200, "text/html", INDEX_HTML);
}

void routeCmd() {
  if (!server.hasArg("k") || server.arg("k").isEmpty()) {
    server.send(400, "application/json", "{\"e\":1}"); return;
  }
  const char c = server.arg("k")[0];
  breathing = false;   // user interacted — stop the notification pulse
  sleeping  = false;

  if (termMode) {
    if (c == 'q') { termMode = false; drawCodeView(); }
    server.send(200, "application/json", "{\"ok\":1}"); return;
  }

  server.send(200, "application/json", "{\"ok\":1}");
  switch (c) {
    case 'w': currentView = VIEW_EYES_NORMAL; faceIdx = 0; animNormalEyes(); break;
    case 's': currentView = VIEW_EYES_SQUISH; faceIdx = 1; animSquishEyes(); break;
    case 'd':
      currentView = VIEW_CODE; drawCodeView();
      termMode = true; termClear(); termFullRedraw(); break;
    case 'a':
      currentView = VIEW_EYES_NORMAL;
      animLogoReveal();
      break;
  }
}

void routeChar() {
  if (!termMode) { server.send(200, "application/json", "{\"ok\":1}"); return; }
  const String val = server.arg("c");
  if (val.length() > 0) termAddChar(val[0]);
  server.send(200, "application/json", "{\"ok\":1}");
}

void routeSpeed() {
  if (server.hasArg("v")) animSpeed = constrain(server.arg("v").toInt(), 1, 3);
  server.send(200, "application/json", "{\"ok\":1}");
}

void drawCurrentView() {
  switch (currentView) {
    case VIEW_EYES_NORMAL: drawNormalEyes(); break;
    case VIEW_EYES_SQUISH: drawSquishEyes(); break;
    case VIEW_CODE:        drawCodeView();   break;
    case VIEW_DRAW:        tft.fillScreen(drawBgColor); break;
  }
}

// /redraw?bg=hex — set animBg and immediately redraw current view
void routeRedraw() {
  if (server.hasArg("bg")) {
    animBgColor = hexToRgb565(server.arg("bg"));
    drawBgColor = animBgColor;
  }
  drawCurrentView();
  server.send(200, "application/json", "{\"ok\":1}");
}

void routeCanvas() {
  const bool on = server.hasArg("on") && server.arg("on") == "1";
  if (on) { currentView = VIEW_DRAW; tft.fillScreen(drawBgColor); }
  server.send(200, "application/json", "{\"ok\":1}");
}

void routeDrawClear() {
  const String bg = server.hasArg("bg") ? server.arg("bg") : "#aa4818";
  drawBgColor = hexToRgb565(bg);
  animBgColor = drawBgColor;  // keep in sync
  currentView = VIEW_DRAW; termMode = false;
  tft.fillScreen(drawBgColor);
  server.send(200, "application/json", "{\"ok\":1}");
}

void routeDrawStroke() {
  if (!server.hasArg("pts") || !server.hasArg("pen")) {
    server.send(200, "application/json", "{\"ok\":1}"); return;
  }
  const uint16_t color = hexToRgb565(server.arg("pen"));
  const String   data  = server.arg("pts");
  currentView = VIEW_DRAW;

  struct Pt { int16_t x, y; };
  Pt prev = {-1, -1};
  int start = 0;
  while (start < (int)data.length()) {
    int semi = data.indexOf(';', start);
    if (semi == -1) semi = data.length();
    String entry = data.substring(start, semi);
    const int comma = entry.indexOf(',');
    if (comma > 0) {
      const int16_t x = entry.substring(0, comma).toInt();
      const int16_t y = entry.substring(comma + 1).toInt();
      if (prev.x >= 0) {
        tft.drawLine(prev.x, prev.y, x, y, color);
        tft.drawLine(prev.x + 1, prev.y, x + 1, y, color);
        tft.drawLine(prev.x, prev.y + 1, x, y + 1, color);
      } else {
        tft.fillCircle(x, y, 2, color);
      }
      prev = {x, y};
    }
    start = semi + 1;
  }
  server.send(200, "application/json", "{\"ok\":1}");
}

void routeBacklight() {
  setBacklight(server.hasArg("on") && server.arg("on") == "1");
  server.send(200, "application/json", "{\"ok\":1}");
}

// /notify — for bots/scripts (trading bot, Claude Code hooks):
//   view=w|s|d   switch face (normal / squish / code view)
//   msg=...      open the terminal and type the message out
//   alert=good|bad  flash the whole screen green/red 3× (visible from afar)
//   breathe=1|0  pulse the backlight until the next interaction
//   sleep=1|0    PC locked/unlocked — close eyes & dim, or wake back up
//   face=0..9    jump straight to a specific face
//   bg=RRGGBB    optional background colour, hex without '#'
void routeNotify() {
  if (server.hasArg("bg")) {
    animBgColor = hexToRgb565(server.arg("bg"));
    drawBgColor = animBgColor;
  }
  const String v     = server.arg("view");
  const String msg   = server.arg("msg");
  const String alert = server.arg("alert");
  if (server.hasArg("breathe")) breathing = server.arg("breathe") == "1";
  server.send(200, "application/json", "{\"ok\":1}");
  if (server.hasArg("sleep")) {
    const bool toSleep = server.arg("sleep") == "1";
    if (toSleep && !sleeping) {
      sleeping = true; breathing = false; termMode = false;
      currentView = VIEW_EYES_NORMAL;
      drawNormalEyes(0, true);           // eyes shut
    } else if (!toSleep && sleeping) {
      sleeping = false;
      animNormalEyes();                  // wake-up wiggle & blink
    }
    return;
  }
  if (server.hasArg("face")) {
    breathing = false; sleeping = false; termMode = false;
    faceIdx = constrain(server.arg("face").toInt(), 0, FACE_COUNT - 1);
    currentView = (faceIdx == 1) ? VIEW_EYES_SQUISH : VIEW_EYES_NORMAL;
    drawFace(faceIdx);
    return;
  }
  if (alert.length() > 0 || v.length() > 0 || msg.length() > 0) {
    breathing = false;   // a fresh event supersedes the standby pulse
    sleeping  = false;
  }
  if (alert.length() > 0) {
    busy = true;
    const uint16_t col = (alert == "bad") ? tft.color565(230, 30, 30)
                                          : tft.color565(30, 210, 90);
    for (uint8_t i = 0; i < 3; i++) {
      tft.fillScreen(col);     delay(170);
      tft.fillScreen(C_BLACK); delay(110);
    }
    busy = false;
    drawCurrentView();
  } else if (msg.length() > 0) {
    currentView = VIEW_CODE;
    termMode = true; termClear(); termFullRedraw();
    for (unsigned int i = 0; i < msg.length(); i++) termAddChar(msg[i]);
  } else if (v.length() > 0) {
    switch (v[0]) {
      case 'w': termMode = false; currentView = VIEW_EYES_NORMAL; faceIdx = 0; animNormalEyes(); break;
      case 's': termMode = false; currentView = VIEW_EYES_SQUISH; faceIdx = 1; animSquishEyes(); break;
      case 'd': termMode = false; currentView = VIEW_CODE; drawCodeView(); break;
    }
  }
}

// Convert RGB565 back to #RRGGBB for state endpoint
String rgb565ToHex(uint16_t c) {
  uint8_t r = ((c >> 11) & 0x1F) << 3;
  uint8_t g = ((c >> 5)  & 0x3F) << 2;
  uint8_t b = (c & 0x1F) << 3;
  char buf[8];
  snprintf(buf, sizeof(buf), "#%02x%02x%02x", r, g, b);
  return String(buf);
}

void routeState() {
  String j = "{\"view\":"; j += currentView;
  j += ",\"busy\":";   j += busy        ? "true" : "false";
  j += ",\"term\":";   j += termMode    ? "true" : "false";
  j += ",\"bl\":";     j += backlightOn ? "true" : "false";
  j += ",\"speed\":";  j += animSpeed;
  j += "}";
  server.send(200, "application/json", j);
}

void routeNotFound() { server.send(404, "text/plain", "not found"); }

// POST /update with the .bin as a multipart file — the browser/curl pushes to
// us, so there's no call-back-to-host leg for a firewall to block and no
// custom protocol to time out. espota's job, done over plain HTTP:
//   curl -F "f=@clawd_mochi.ino.bin" http://clawdmochi.local/update
void routeUpdateUpload() {
  HTTPUpload& up = server.upload();
  if (up.status == UPLOAD_FILE_START) {
    setBacklight(true);
    tft.fillScreen(C_DARKBG);
    tft.setTextColor(C_ORANGE); tft.setTextSize(2);
    tft.setCursor(12, 100); tft.print("updating...");
    Update.begin(UPDATE_SIZE_UNKNOWN);
  } else if (up.status == UPLOAD_FILE_WRITE) {
    Update.write(up.buf, up.currentSize);
  } else if (up.status == UPLOAD_FILE_END) {
    if (!Update.end(true)) drawCurrentView();   // failed — don't strand the screen
  } else if (up.status == UPLOAD_FILE_ABORTED) {
    Update.abort();                             // else a dead upload blocks all retries
    drawCurrentView();
  }
}

// ═════════════════════════════════════════════════════════════
//  SETUP
// ═════════════════════════════════════════════════════════════

void setup() {
  Serial.begin(115200);

  ledcAttach(TFT_BLK, 5000, 8);   // PWM so the backlight can breathe/dim
  ledcWrite(TFT_BLK, 255);
  setBacklight(true);

  SPI.begin(8, -1, 10, TFT_CS);   // SCK=8, MOSI=10
  tft.init(240, 240);
  tft.setSPISpeed(40000000);
  tft.setRotation(1);
  initColours();

  // ── Boot splash ────────────────────────────────────────────
  tft.fillScreen(animBgColor);
  tft.setTextColor(C_WHITE); tft.setTextSize(3);
  tft.setCursor(DISP_W / 2 - 54, DISP_H / 2 - 22); tft.print("Clawd");
  tft.setCursor(DISP_W / 2 - 54, DISP_H / 2 + 14); tft.print("Mochi");
  delay(1200);

  // ── Logo shown once at startup ─────────────────────────────
  animLogoReveal();

  // ── Start WiFi ─────────────────────────────────────────────
  // Try joining home WiFi (STA) first if credentials are set; fall back
  // to hosting the hotspot (AP) if that's not set or the join times out.
  bool staConnected = false;
  if (strlen(STA_SSID) > 0) {
    WiFi.mode(WIFI_STA);
    Serial.printf("[STA] connecting to %s\n", STA_SSID);
    // ESP32-C3 SuperMini antenna quirk: full TX power distorts the signal
    // and the router never completes the handshake — lower power fixes it.
    WiFi.setTxPower(WIFI_POWER_8_5dBm);
    staBegin();
    uint32_t t0 = millis();
    while (WiFi.status() != WL_CONNECTED && millis() - t0 < STA_TIMEOUT_MS) delay(200);
    staConnected = WiFi.status() == WL_CONNECTED;
    // Modem sleep parks the radio between beacons — pings jump to ~200ms and
    // a sustained OTA transfer drops mid-flight. Keep the radio awake.
    if (staConnected) WiFi.setSleep(false);
    Serial.printf("[STA] %s, IP: %s\n", staConnected ? "CONNECTED" : "FAILED — falling back to AP",
                  WiFi.localIP().toString().c_str());
  }
  configTzTime(TZ_STRING, "pool.ntp.org");   // SNTP keeps retrying once network is up
  if (staConnected) {
    staUp = true;
    MDNS.begin("clawdmochi");
  } else {
    WiFi.mode(WIFI_AP);
    WiFi.softAP(AP_SSID, AP_PASS);
  }

  // ── WiFi info screen (stays until first web request) ───────
  tft.fillScreen(C_DARKBG);
  tft.fillRect(0, 0, DISP_W, 4, C_ORANGE);
  if (staConnected) {
    tft.setTextColor(C_WHITE);  tft.setTextSize(2);
    tft.setCursor(12, 16);  tft.print("WiFi: ");   tft.print(STA_SSID);
    tft.setTextColor(C_WHITE);  tft.setTextSize(2);
    tft.setCursor(12, 68);  tft.print("Open browser:");
    tft.setTextColor(C_ORANGE); tft.setTextSize(2);
    tft.setCursor(12, 94);  tft.print("clawdmochi.local");
    tft.setTextColor(C_MUTED);  tft.setTextSize(1);
    tft.setCursor(12, 118); tft.print("or ");       tft.print(WiFi.localIP());
    tft.setCursor(12, 132); tft.print("press any button to start");
  } else {
    tft.setTextColor(C_WHITE);  tft.setTextSize(2);
    tft.setCursor(12, 16);  tft.print("WiFi: ClaWD-Mochi");
    tft.setTextColor(C_MUTED);  tft.setTextSize(1);
    tft.setCursor(12, 44);  tft.print("password: clawd1234");
    tft.setTextColor(C_WHITE);  tft.setTextSize(2);
    tft.setCursor(12, 68);  tft.print("Open browser:");
    tft.setTextColor(C_ORANGE); tft.setTextSize(2);
    tft.setCursor(12, 94);  tft.print("192.168.4.1");
    tft.setTextColor(C_MUTED);  tft.setTextSize(1);
    tft.setCursor(12, 124); tft.print("press any button to start");
  }

  // ── Register routes ────────────────────────────────────────
  server.on("/",            HTTP_GET, routeRoot);
  server.on("/cmd",         HTTP_GET, routeCmd);
  server.on("/char",        HTTP_GET, routeChar);
  server.on("/speed",       HTTP_GET, routeSpeed);
  server.on("/redraw",      HTTP_GET, routeRedraw);
  server.on("/canvas",      HTTP_GET, routeCanvas);
  server.on("/draw/clear",  HTTP_GET, routeDrawClear);
  server.on("/draw/stroke", HTTP_GET, routeDrawStroke);
  server.on("/backlight",   HTTP_GET, routeBacklight);
  server.on("/notify",                routeNotify);   // GET or POST
  server.on("/state",       HTTP_GET, routeState);
  server.on("/update", HTTP_POST, []() {
    const bool ok = !Update.hasError();
    server.send(200, "text/plain", ok ? "OK — rebooting" : "FAILED");
    if (ok) { delay(300); ESP.restart(); }
  }, routeUpdateUpload);
  server.onNotFound(routeNotFound);
  server.begin();

  // WiFi info stays on screen — first button press triggers setView/cmd
  // which will replace it with the correct view
}

// ═════════════════════════════════════════════════════════════
//  LOOP
// ═════════════════════════════════════════════════════════════

void loop() {
  server.handleClient();
  idleTick();
  wifiTick();
  blTick();
}
